gorkemorakbicen/28V-Power-Control-Interface/docs/BOM.xlsx

Sheet: BOM - Gruplu
Referanslar | Adet | Tür | Değer | Üretici | MPN | Footprint | Montaj | Kaynak URL
L1 | 1 | Bobin | 47uH | Coilcraft | MSS1260T-473MLD | Inductor_SMD:L_Coilcraft_MSS1260-XXX | Montaj | https://www.coilcraft.com/en-us/products/power/shielded-inductors/ferrite-drum/mss-mos/mss1260t/mss1260t-473/
SW1 | 1 | Buton | SW_Push | Omron | B3U-1000P | Button_Switch_SMD:SW_SPST_B3U-1000P | Montaj | https://omronfs.omron.com/en_US/ecb/products/pdf/en-b3u.pdf
R1 | 1 | Direnç | 3.3k | Yageo | AC1206FR-073K3L | Resistor_SMD:R_1206_3216Metric | Montaj | https://yageogroup.com/component-documentation/download/specsheet/AC1206FR-073K3L
R13 | 1 | Direnç | 1k | Yageo | AC0603FR-071KL | Resistor_SMD:R_0603_1608Metric | Montaj | https://www.digikey.com/en/products/detail/yageo/AC0603FR-071KL/2828140
R15 | 1 | Direnç | 120 (DNP) | Yageo | AC1206FR-07120RL | Resistor_SMD:R_1206_3216Metric | DNP | https://www.digikey.com/en/products/detail/yageo/AC1206FR-07120RL/5897228
R2 | 1 | Direnç | 1M | Yageo | AC0603FR-071ML | Resistor_SMD:R_0603_1608Metric | Montaj | https://www.digikey.com/en/products/detail/yageo/AC0603FR-071ML/2828141
R3 | 1 | Direnç | 200k | Yageo | AC0603FR-07200KL | Resistor_SMD:R_0603_1608Metric | Montaj | https://yageogroup.com/component-documentation/download/specsheet/AC0603FR-07200KL
R4 | 1 | Direnç | 316k | Yageo | RT0603BRD07316KL | Resistor_SMD:R_0603_1608Metric | Montaj | https://www.digikey.com/en/products/detail/yageo/RT0603BRD07316KL/6616687
R5 | 1 | Direnç | 100k | Yageo | AC0603FR-07100KL | Resistor_SMD:R_0603_1608Metric | Montaj | https://yageogroup.com/component-documentation/download/specsheet/AC0603FR-07100KL
R6 | 1 | Direnç | 41.2k | Yageo | AC0603FR-0741K2L | Resistor_SMD:R_0603_1608Metric | Montaj | https://www.digikey.com/en/products/detail/yageo/AC0603FR-0741K2L/5896114
R7 | 1 | Direnç | 100k | Yageo | RT0603BRD07100KL | Resistor_SMD:R_0603_1608Metric | Montaj | https://yageogroup.com/component-documentation/download/specsheet/RT0603BRD07100KL
R8, R10 | 2 | Direnç | 165k | Yageo | AC0603FR-07165KL | Resistor_SMD:R_0603_1608Metric | Montaj | https://www.digikey.com/en/products/detail/yageo/AC0603FR-07165KL/5895810
R9, R11, R12, R14 | 4 | Direnç | 10k | Yageo | AC0603FR-0710KL | Resistor_SMD:R_0603_1608Metric | Montaj | https://www.digikey.com/en/products/detail/yageo/AC0603FR-0710KL/2827814
D1 | 1 | Diyot/LED | BZT52C12Q | Diodes Incorporated | BZT52C12Q-7-F | Diode_SMD:D_SOD-123 | Montaj | https://www.digikey.com/en/products/detail/diodes-incorporated/BZT52C12Q-7-F/16548866
D2 | 1 | Diyot/LED | SMBJ36CA | Littelfuse | SMBJ36CA | Diode_SMD:D_SMB | Montaj | https://www.littelfuse.com/assetdocs/tvs-diodes-smbj-series-datasheet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
D3 | 1 | Diyot/LED | LED_RED | Lite-On | LTST-C190KRKT | LED_SMD:LED_0603_1608Metric | Montaj | https://www.digikey.com/en/products/detail/liteon/LTST-C190KRKT/386817
D4 | 1 | Diyot/LED | PESD2CANFD24V-T | Nexperia | PESD2CANFD24V-T | Package_TO_SOT_SMD:SOT-23 | Montaj | https://assets.nexperia.com/documents/data-sheet/PESD2CANFD24V-T.pdf
U1 | 1 | Entegre | LM5164DDA | Texas Instruments | LM5164DDAT | Package_SO:HSOP-8-1EP_3.9x4.9mm_P1.27mm_EP2.41x3.1mm_ThermalVias | Montaj | https://www.ti.com/lit/ds/symlink/lm5164.pdf?ts=1598311864250
U2 | 1 | Entegre | TLV75533PDBV | Texas Instruments | TLV75533PDBVR | Package_TO_SOT_SMD:SOT-23-5 | Montaj | http://www.ti.com/lit/ds/symlink/tlv755p.pdf
U3 | 1 | Entegre | STM32G0B1CBTx | STMicroelectronics | STM32G0B1CBT6 | Package_QFP:LQFP-48_7x7mm_P0.5mm | Montaj | https://www.st.com/resource/en/datasheet/stm32g0b1cb.pdf
U4 | 1 | Entegre | TJA1049T-3 | NXP | TJA1049T/3/1Z | Package_SO:SOIC-8_3.9x4.9mm_P1.27mm | Montaj | http://www.nxp.com/docs/en/data-sheet/TJA1049.pdf
C1 | 1 | Kondansatör | 2.2nF | Murata | GCM155R71H222KA37D | Capacitor_SMD:C_0402_1005Metric | Montaj | https://www.digikey.com/en/products/detail/murata-electronics/GCM155R71H222KA37D/1765162
C11, C13, C16, C18, C19 | 5 | Kondansatör | 100nF | Murata | GRM188R72A104KA35D | Capacitor_SMD:C_0603_1608Metric | Montaj | https://www.digikey.com/en/products/detail/murata-electronics/GRM188R72A104KA35D/702549
C12 | 1 | Kondansatör | 4.7uF | TDK | C2012X7R1C475K125AB | Capacitor_SMD:C_0805_2012Metric | Montaj | https://www.digikey.lv/en/products/detail/tdk/C2012X7R1C475K125AB/2619200
C14, C15 | 2 | Kondansatör | 10nF | Murata | GRM188R72A103KA01D | Capacitor_SMD:C_0603_1608Metric | Montaj | https://www.digikey.com/en/products/detail/murata-electronics/GRM188R72A103KA01D/2612560
C17 | 1 | Kondansatör | 1uF | Murata | GRM21BR71C105KA01L | Capacitor_SMD:C_0805_2012Metric | Montaj | https://www.digikey.com/en/products/detail/murata-electronics/GRM21BR71C105KA01L/586698
C2 | 1 | Kondansatör | 22uF/100V | Nichicon | UCZ2A220MCS1GS | Capacitor_SMD:CP_Elec_10x10 | Montaj | https://www.nichicon.com/en-us/part/ucz2a220mcs1gs/3000/
C20, C21 | 2 | Kondansatör | 12pF | TDK | CGA3E2C0G1H120J080AA | Capacitor_SMD:C_0603_1608Metric | Montaj | https://product.tdk.com/system/files/dam/doc/product/capacitor/ceramic/mlcc/catalog/mlcc_automotive_general_en.pdf
C3, C4 | 2 | Kondansatör | 2.2uF | TDK | CGA6N3X7R2A225K230AB | Capacitor_SMD:C_1210_3225Metric | Montaj | https://product.tdk.com/en/search/capacitor/ceramic/mlcc/info?part_no=CGA6N3X7R2A225K230AB
C5 | 1 | Kondansatör | 3.3nF | Murata | GRM188R72A332KA01D | Capacitor_SMD:C_0603_1608Metric | Montaj | https://www.digikey.com/en/products/detail/murata-electronics/GRM188R72A332KA01D/587141
C6 | 1 | Kondansatör | 22uF | TDK | CGA6P1X7R1C226M250AC | Capacitor_SMD:C_1210_3225Metric | Montaj | https://product.tdk.com/en/search/capacitor/ceramic/mlcc/info?part_no=CGA6P1X7R1C226M250AC
C7 | 1 | Kondansatör | 22uF (DNP) | TDK | CGA6P1X7R1C226M250AC | Capacitor_SMD:C_1210_3225Metric | DNP | https://product.tdk.com/en/search/capacitor/ceramic/mlcc/info?part_no=CGA6P1X7R1C226M250AC
C8 | 1 | Kondansatör | 82pF | TDK | CGA3E2C0G1H820J080AA | Capacitor_SMD:C_0603_1608Metric | Montaj | https://product.tdk.com/en/search/capacitor/ceramic/mlcc/info?part_no=CGA3E2C0G1H820J080AA
C9, C10 | 2 | Kondansatör | 2.2uF | Murata | GRM21BR71C225KA12L | Capacitor_SMD:C_0805_2012Metric | Montaj | https://www.digikey.com/en/products/detail/murata-electronics/GRM21BR71C225KA12L/965920
J1 | 1 | Konnektör | Screw_Terminal_01x02 | Phoenix Contact | 1715721 | TerminalBlock_Phoenix:TerminalBlock_Phoenix_MKDS-1,5-2-5.08_1x02_P5.08mm_Horizontal | Montaj | https://www.phoenixcontact.com/tr-tr/urunler/baskili-devre-levhasi-terminali-mkds-15-2-508-1715721
J2 | 1 | Konnektör | Conn_01x05_Pin | Würth Elektronik | 61300511121 | Connector_PinHeader_2.54mm:PinHeader_1x05_P2.54mm_Vertical | Montaj | https://www.digikey.com/en/products/detail/w%C3%BCrth-elektronik/61300511121/4846831
J3 | 1 | Konnektör | Screw_Terminal_01x03 | Phoenix Contact | 1715734 | TerminalBlock_Phoenix:TerminalBlock_Phoenix_MKDS-1,5-3-5.08_1x03_P5.08mm_Horizontal | Montaj | https://www.phoenixcontact.com/tr-tr/urunler/baskili-devre-levhasi-terminali-mkds-15-3-508-1715734
Y1 | 1 | Kristal | 16MHz | Kyocera | CX3225FB16000F0FZZH1 | Crystal:Crystal_SMD_3225-4Pin_3.2x2.5mm | Montaj | https://ele.kyocera.com/assets/products/crystal-device/specification/CX3225FB_10pF.pdf
Q1 | 1 | MOSFET | SQM100P10-19L | Vishay | SQM100P10-19L_GE3 | Package_TO_SOT_SMD:TO-263-3_TabPin2 | Montaj | https://www.vishay.com/docs/75583/sqm100p10-19l.pdf
F1 | 1 | Sigorta | 1A | Littelfuse | 0451001.MRL | Fuse:Fuse_Littelfuse-NANO2-451_453 | Montaj | https://www.littelfuse.com/assetdocs/fuse-451-and-453-datasheet?assetguid=533cd5cc-956c-4243-867f-6ab5a62f6ba1

Sheet: BOM - Tekil
Ref | Tür | Değer | Üretici | MPN | Footprint | Montaj | Kaynak URL
C1 | Kondansatör | 2.2nF | Murata | GCM155R71H222KA37D | Capacitor_SMD:C_0402_1005Metric | Montaj | https://www.digikey.com/en/products/detail/murata-electronics/GCM155R71H222KA37D/1765162
C2 | Kondansatör | 22uF/100V | Nichicon | UCZ2A220MCS1GS | Capacitor_SMD:CP_Elec_10x10 | Montaj | https://www.nichicon.com/en-us/part/ucz2a220mcs1gs/3000/
C3 | Kondansatör | 2.2uF | TDK | CGA6N3X7R2A225K230AB | Capacitor_SMD:C_1210_3225Metric | Montaj | https://product.tdk.com/en/search/capacitor/ceramic/mlcc/info?part_no=CGA6N3X7R2A225K230AB
C4 | Kondansatör | 2.2uF | TDK | CGA6N3X7R2A225K230AB | Capacitor_SMD:C_1210_3225Metric | Montaj | https://product.tdk.com/en/search/capacitor/ceramic/mlcc/info?part_no=CGA6N3X7R2A225K230AB
C5 | Kondansatör | 3.3nF | Murata | GRM188R72A332KA01D | Capacitor_SMD:C_0603_1608Metric | Montaj | https://www.digikey.com/en/products/detail/murata-electronics/GRM188R72A332KA01D/587141
C6 | Kondansatör | 22uF | TDK | CGA6P1X7R1C226M250AC | Capacitor_SMD:C_1210_3225Metric | Montaj | https://product.tdk.com/en/search/capacitor/ceramic/mlcc/info?part_no=CGA6P1X7R1C226M250AC
C7 | Kondansatör | 22uF (DNP) | TDK | CGA6P1X7R1C226M250AC | Capacitor_SMD:C_1210_3225Metric | DNP | https://product.tdk.com/en/search/capacitor/ceramic/mlcc/info?part_no=CGA6P1X7R1C226M250AC
C8 | Kondansatör | 82pF | TDK | CGA3E2C0G1H820J080AA | Capacitor_SMD:C_0603_1608Metric | Montaj | https://product.tdk.com/en/search/capacitor/ceramic/mlcc/info?part_no=CGA3E2C0G1H820J080AA
C9 | Kondansatör | 2.2uF | Murata | GRM21BR71C225KA12L | Capacitor_SMD:C_0805_2012Metric | Montaj | https://www.digikey.com/en/products/detail/murata-electronics/GRM21BR71C225KA12L/965920
C10 | Kondansatör | 2.2uF | Murata | GRM21BR71C225KA12L | Capacitor_SMD:C_0805_2012Metric | Montaj | https://www.digikey.com/en/products/detail/murata-electronics/GRM21BR71C225KA12L/965920
C11 | Kondansatör | 100nF | Murata | GRM188R72A104KA35D | Capacitor_SMD:C_0603_1608Metric | Montaj | https://www.digikey.com/en/products/detail/murata-electronics/GRM188R72A104KA35D/702549
C12 | Kondansatör | 4.7uF | TDK | C2012X7R1C475K125AB | Capacitor_SMD:C_0805_2012Metric | Montaj | https://www.digikey.lv/en/products/detail/tdk/C2012X7R1C475K125AB/2619200
C13 | Kondansatör | 100nF | Murata | GRM188R72A104KA35D | Capacitor_SMD:C_0603_1608Metric | Montaj | https://www.digikey.com/en/products/detail/murata-electronics/GRM188R72A104KA35D/702549
C14 | Kondansatör | 10nF | Murata | GRM188R72A103KA01D | Capacitor_SMD:C_0603_1608Metric | Montaj | https://www.digikey.com/en/products/detail/murata-electronics/GRM188R72A103KA01D/2612560
C15 | Kondansatör | 10nF | Murata | GRM188R72A103KA01D | Capacitor_SMD:C_0603_1608Metric | Montaj | https://www.digikey.com/en/products/detail/murata-electronics/GRM188R72A103KA01D/2612560
C16 | Kondansatör | 100nF | Murata | GRM188R72A104KA35D | Capacitor_SMD:C_0603_1608Metric | Montaj | https://www.digikey.com/en/products/detail/murata-electronics/GRM188R72A104KA35D/702549
C17 | Kondansatör | 1uF | Murata | GRM21BR71C105KA01L | Capacitor_SMD:C_0805_2012Metric | Montaj | https://www.digikey.com/en/products/detail/murata-electronics/GRM21BR71C105KA01L/586698
C18 | Kondansatör | 100nF | Murata | GRM188R72A104KA35D | Capacitor_SMD:C_0603_1608Metric | Montaj | https://www.digikey.com/en/products/detail/murata-electronics/GRM188R72A104KA35D/702549
C19 | Kondansatör | 100nF | Murata | GRM188R72A104KA35D | Capacitor_SMD:C_0603_1608Metric | Montaj | https://www.digikey.com/en/products/detail/murata-electronics/GRM188R72A104KA35D/702549
C20 | Kondansatör | 12pF | TDK | CGA3E2C0G1H120J080AA | Capacitor_SMD:C_0603_1608Metric | Montaj | https://product.tdk.com/system/files/dam/doc/product/capacitor/ceramic/mlcc/catalog/mlcc_automotive_general_en.pdf
C21 | Kondansatör | 12pF | TDK | CGA3E2C0G1H120J080AA | Capacitor_SMD:C_0603_1608Metric | Montaj | https://product.tdk.com/system/files/dam/doc/product/capacitor/ceramic/mlcc/catalog/mlcc_automotive_general_en.pdf
D1 | Diyot/LED | BZT52C12Q | Diodes Incorporated | BZT52C12Q-7-F | Diode_SMD:D_SOD-123 | Montaj | https://www.digikey.com/en/products/detail/diodes-incorporated/BZT52C12Q-7-F/16548866
D2 | Diyot/LED | SMBJ36CA | Littelfuse | SMBJ36CA | Diode_SMD:D_SMB | Montaj | https://www.littelfuse.com/assetdocs/tvs-diodes-smbj-series-datasheet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
D3 | Diyot/LED | LED_RED | Lite-On | LTST-C190KRKT | LED_SMD:LED_0603_1608Metric | Montaj | https://www.digikey.com/en/products/detail/liteon/LTST-C190KRKT/386817
D4 | Diyot/LED | PESD2CANFD24V-T | Nexperia | PESD2CANFD24V-T | Package_TO_SOT_SMD:SOT-23 | Montaj | https://assets.nexperia.com/documents/data-sheet/PESD2CANFD24V-T.pdf
F1 | Sigorta | 1A | Littelfuse | 0451001.MRL | Fuse:Fuse_Littelfuse-NANO2-451_453 | Montaj | https://www.littelfuse.com/assetdocs/fuse-451-and-453-datasheet?assetguid=533cd5cc-956c-4243-867f-6ab5a62f6ba1
J1 | Konnektör | Screw_Terminal_01x02 | Phoenix Contact | 1715721 | TerminalBlock_Phoenix:TerminalBlock_Phoenix_MKDS-1,5-2-5.08_1x02_P5.08mm_Horizontal | Montaj | https://www.phoenixcontact.com/tr-tr/urunler/baskili-devre-levhasi-terminali-mkds-15-2-508-1715721
J2 | Konnektör | Conn_01x05_Pin | Würth Elektronik | 61300511121 | Connector_PinHeader_2.54mm:PinHeader_1x05_P2.54mm_Vertical | Montaj | https://www.digikey.com/en/products/detail/w%C3%BCrth-elektronik/61300511121/4846831
J3 | Konnektör | Screw_Terminal_01x03 | Phoenix Contact | 1715734 | TerminalBlock_Phoenix:TerminalBlock_Phoenix_MKDS-1,5-3-5.08_1x03_P5.08mm_Horizontal | Montaj | https://www.phoenixcontact.com/tr-tr/urunler/baskili-devre-levhasi-terminali-mkds-15-3-508-1715734
L1 | Bobin | 47uH | Coilcraft | MSS1260T-473MLD | Inductor_SMD:L_Coilcraft_MSS1260-XXX | Montaj | https://www.coilcraft.com/en-us/products/power/shielded-inductors/ferrite-drum/mss-mos/mss1260t/mss1260t-473/
Q1 | MOSFET | SQM100P10-19L | Vishay | SQM100P10-19L_GE3 | Package_TO_SOT_SMD:TO-263-3_TabPin2 | Montaj | https://www.vishay.com/docs/75583/sqm100p10-19l.pdf
R1 | Direnç | 3.3k | Yageo | AC1206FR-073K3L | Resistor_SMD:R_1206_3216Metric | Montaj | https://yageogroup.com/component-documentation/download/specsheet/AC1206FR-073K3L
R2 | Direnç | 1M | Yageo | AC0603FR-071ML | Resistor_SMD:R_0603_1608Metric | Montaj | https://www.digikey.com/en/products/detail/yageo/AC0603FR-071ML/2828141
R3 | Direnç | 200k | Yageo | AC0603FR-07200KL | Resistor_SMD:R_0603_1608Metric | Montaj | https://yageogroup.com/component-documentation/download/specsheet/AC0603FR-07200KL
R4 | Direnç | 316k | Yageo | RT0603BRD07316KL | Resistor_SMD:R_0603_1608Metric | Montaj | https://www.digikey.com/en/products/detail/yageo/RT0603BRD07316KL/6616687
R5 | Direnç | 100k | Yageo | AC0603FR-07100KL | Resistor_SMD:R_0603_1608Metric | Montaj | https://yageogroup.com/component-documentation/download/specsheet/AC0603FR-07100KL
R6 | Direnç | 41.2k | Yageo | AC0603FR-0741K2L | Resistor_SMD:R_0603_1608Metric | Montaj | https://www.digikey.com/en/products/detail/yageo/AC0603FR-0741K2L/5896114
R7 | Direnç | 100k | Yageo | RT0603BRD07100KL | Resistor_SMD:R_0603_1608Metric | Montaj | https://yageogroup.com/component-documentation/download/specsheet/RT0603BRD07100KL
R8 | Direnç | 165k | Yageo | AC0603FR-07165KL | Resistor_SMD:R_0603_1608Metric | Montaj | https://www.digikey.com/en/products/detail/yageo/AC0603FR-07165KL/5895810
R9 | Direnç | 10k | Yageo | AC0603FR-0710KL | Resistor_SMD:R_0603_1608Metric | Montaj | https://www.digikey.com/en/products/detail/yageo/AC0603FR-0710KL/2827814
R10 | Direnç | 165k | Yageo | AC0603FR-07165KL | Resistor_SMD:R_0603_1608Metric | Montaj | https://www.digikey.com/en/products/detail/yageo/AC0603FR-07165KL/5895810
R11 | Direnç | 10k | Yageo | AC0603FR-0710KL | Resistor_SMD:R_0603_1608Metric | Montaj | https://www.digikey.com/en/products/detail/yageo/AC0603FR-0710KL/2827814
R12 | Direnç | 10k | Yageo | AC0603FR-0710KL | Resistor_SMD:R_0603_1608Metric | Montaj | https://www.digikey.com/en/products/detail/yageo/AC0603FR-0710KL/2827814
R13 | Direnç | 1k | Yageo | AC0603FR-071KL | Resistor_SMD:R_0603_1608Metric | Montaj | https://www.digikey.com/en/products/detail/yageo/AC0603FR-071KL/2828140
R14 | Direnç | 10k | Yageo | AC0603FR-0710KL | Resistor_SMD:R_0603_1608Metric | Montaj | https://www.digikey.com/en/products/detail/yageo/AC0603FR-0710KL/2827814
R15 | Direnç | 120 (DNP) | Yageo | AC1206FR-07120RL | Resistor_SMD:R_1206_3216Metric | DNP | https://www.digikey.com/en/products/detail/yageo/AC1206FR-07120RL/5897228
SW1 | Buton | SW_Push | Omron | B3U-1000P | Button_Switch_SMD:SW_SPST_B3U-1000P | Montaj | https://omronfs.omron.com/en_US/ecb/products/pdf/en-b3u.pdf
U1 | Entegre | LM5164DDA | Texas Instruments | LM5164DDAT | Package_SO:HSOP-8-1EP_3.9x4.9mm_P1.27mm_EP2.41x3.1mm_ThermalVias | Montaj | https://www.ti.com/lit/ds/symlink/lm5164.pdf?ts=1598311864250
U2 | Entegre | TLV75533PDBV | Texas Instruments | TLV75533PDBVR | Package_TO_SOT_SMD:SOT-23-5 | Montaj | http://www.ti.com/lit/ds/symlink/tlv755p.pdf
U3 | Entegre | STM32G0B1CBTx | STMicroelectronics | STM32G0B1CBT6 | Package_QFP:LQFP-48_7x7mm_P0.5mm | Montaj | https://www.st.com/resource/en/datasheet/stm32g0b1cb.pdf
U4 | Entegre | TJA1049T-3 | NXP | TJA1049T/3/1Z | Package_SO:SOIC-8_3.9x4.9mm_P1.27mm | Montaj | http://www.nxp.com/docs/en/data-sheet/TJA1049.pdf
Y1 | Kristal | 16MHz | Kyocera | CX3225FB16000F0FZZH1 | Crystal:Crystal_SMD_3225-4Pin_3.2x2.5mm | Montaj | https://ele.kyocera.com/assets/products/crystal-device/specification/CX3225FB_10pF.pdf

Sheet: Okuma Kilavuzu
28 V POWER CONTROL INTERFACE — BOM
Toplam footprint | 52
Montajlı bileşen | 50
DNP bileşen | 2
Grupta satır sayısı | 40
Kaynak | KiCad son yüklenen ZIP
Tarih | 16.10.2026
İçerik | Birim fiyat / stok bilgisi doğrulanmadı
KULLANIM VE SINIRLAR
BOM, fiziksel PCB üzerindeki 52 bileşen referansını temel alır. Şematik güç sembolleri (GND/PWR_FLAG) montaj parçası olmadığından dışlanmıştır. C7 ve R15 DNP olarak ayrı tutulmuştur. MPN ve üretici bilgileri şematikteki alanlardan aktarılmıştır; siparişten önce MPN geçerliliği, paket/footprint uyumu, tedarik durumu ve alternatifler üretici/tedarikçi üzerinden yeniden teyit edilmelidir. Fiyatlar eklenmemiştir.
