gorkemorakbicen/28V-Power-Control-Interface/docs/Complete_Schematic.pdf

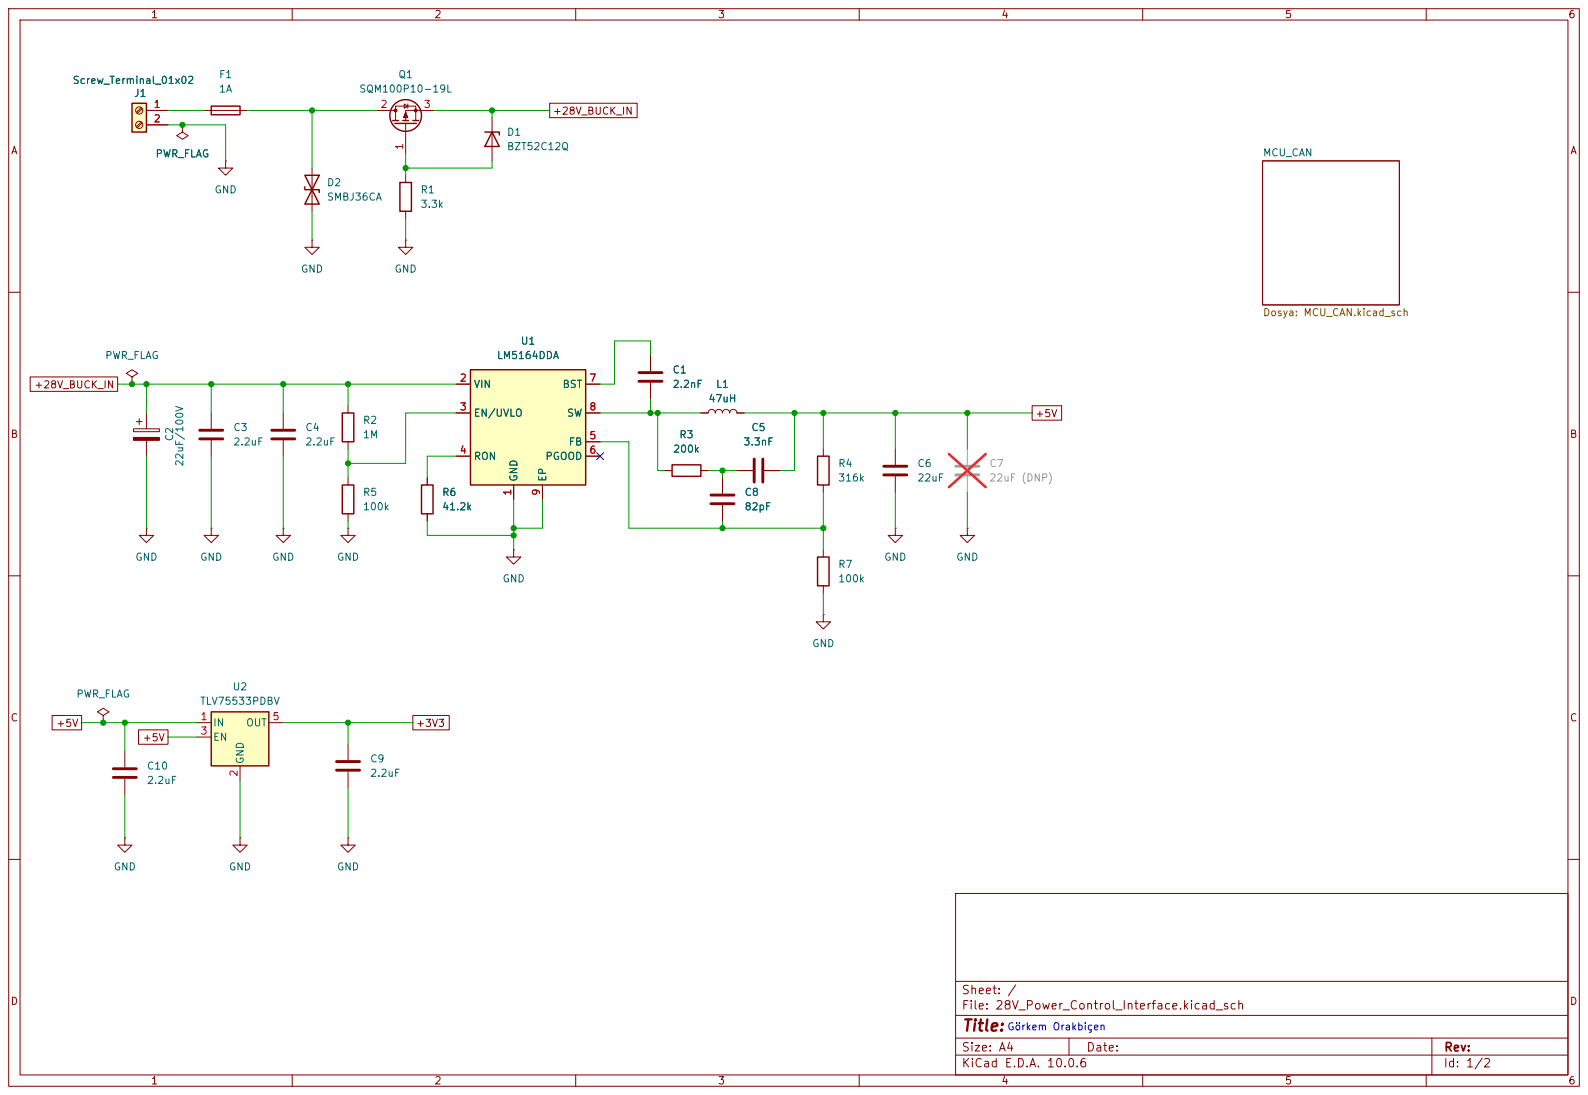
[picture p10: page 1]

Size: A4 | Rev:
KiCad E.D.A. 10.0.6 | Id: 1/2

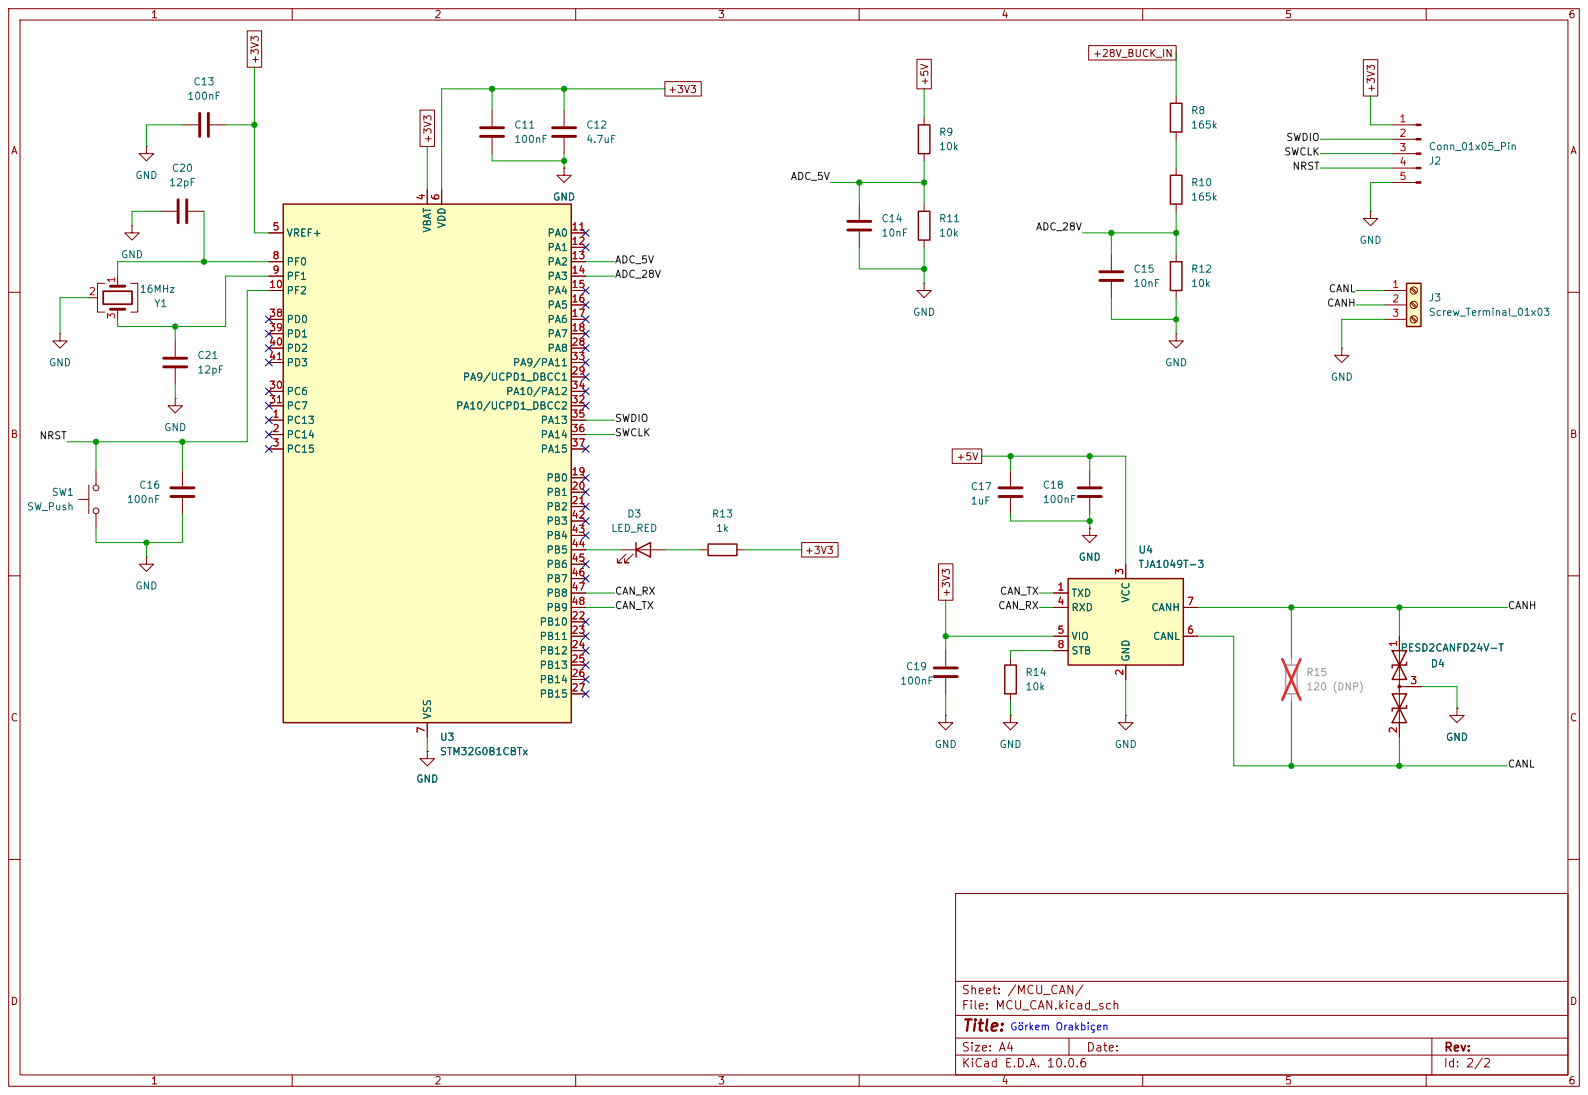
[picture p11: page 2]

Size: A4 | Rev:
KiCad E.D.A. 10.0.6 | Id: 2/2
