gorkemorakbicen/28V-Power-Control-Interface/docs/PCB_Layer_Exports.pdf

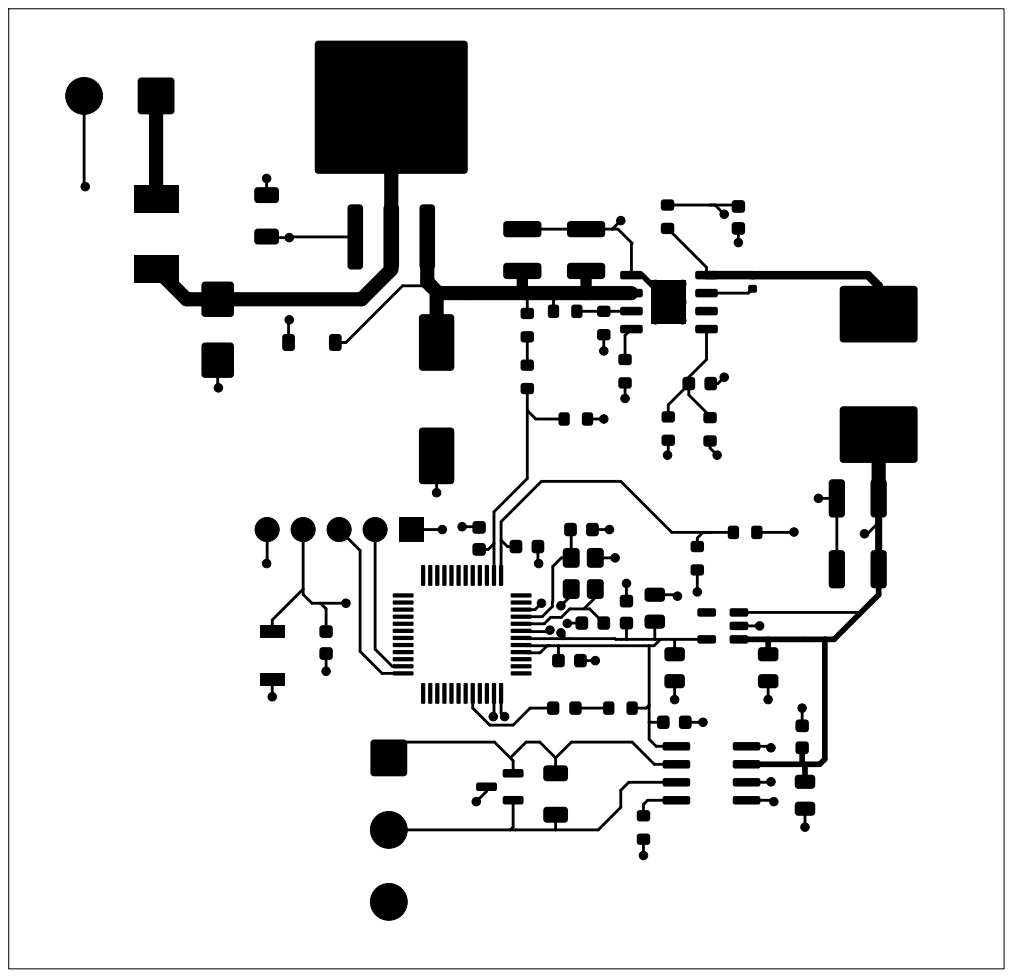
[picture p12: page 1]

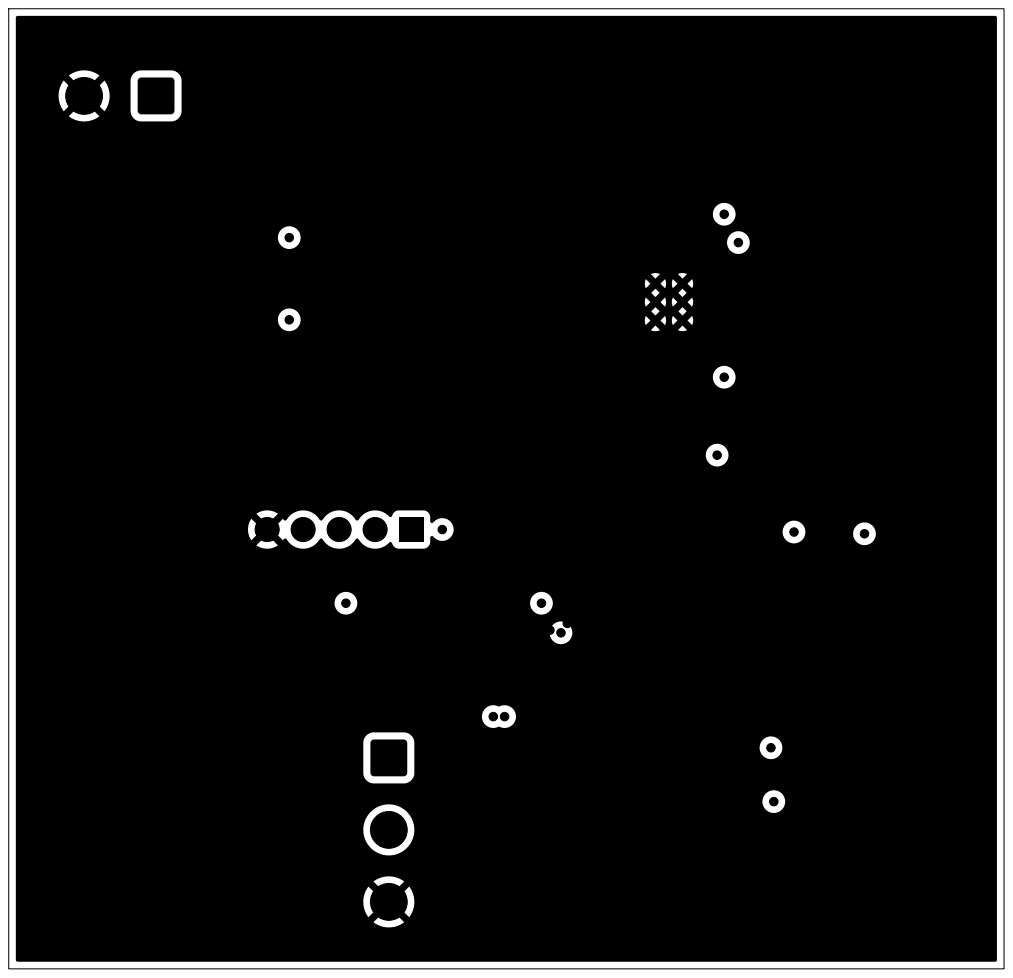
[picture p13: page 2]

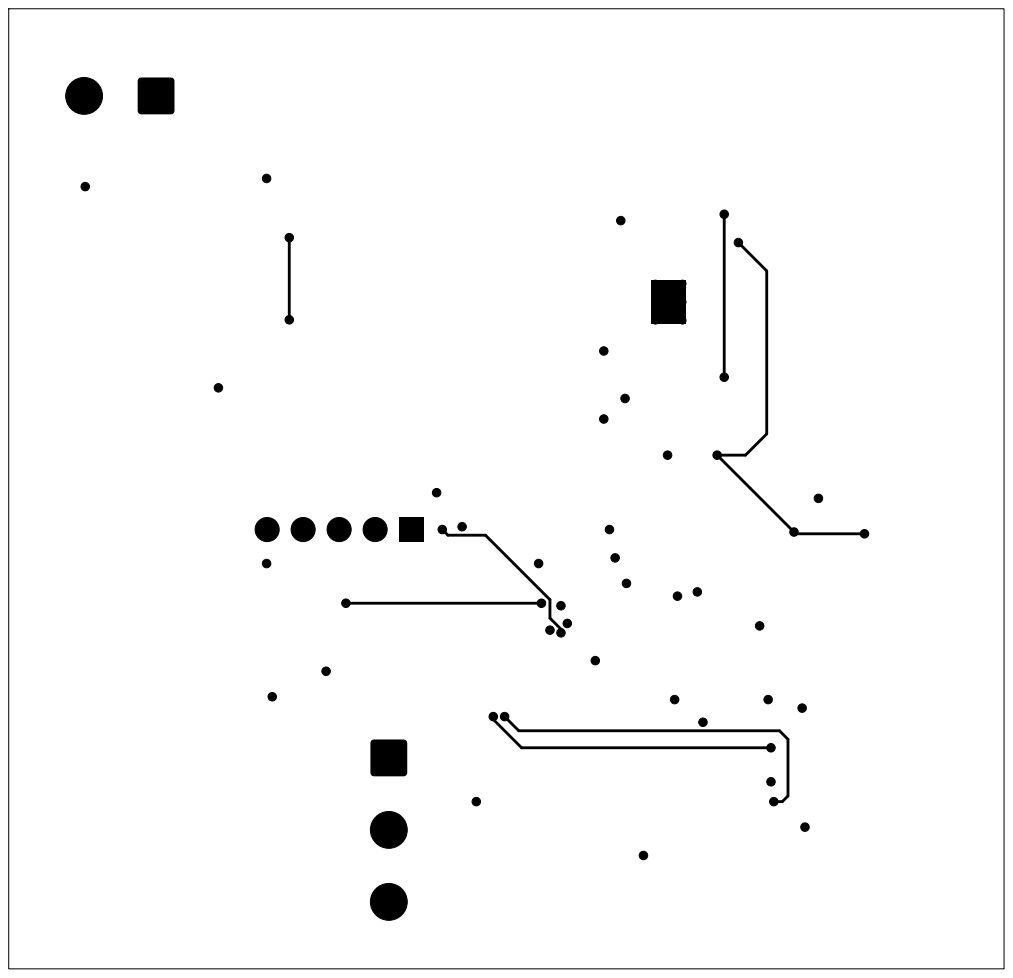
[picture p14: page 4]
