gorkemorakbicen/28V-Power-Control-Interface/docs/PCB_Top_Layer_View.pdf

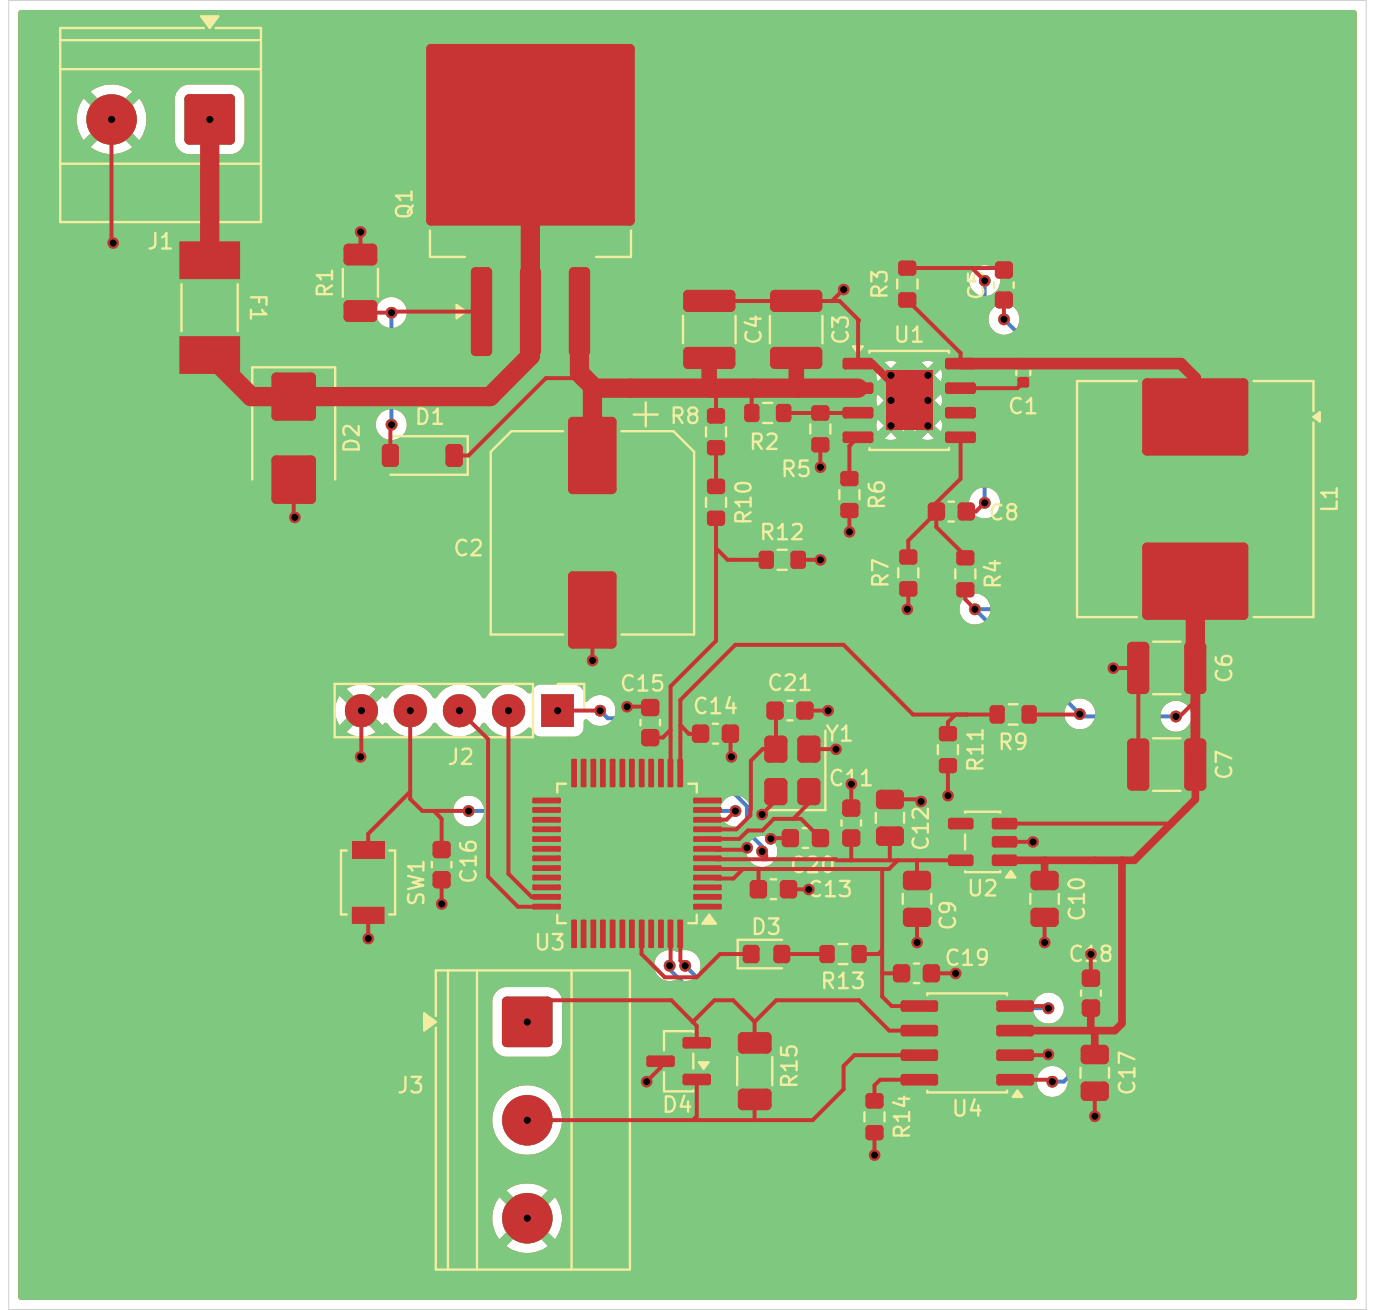
[picture p15: page 1]
