gorkemorakbicen/28V-Power-Control-Interface/hardware/28V_Power_Control_Interface.kicad_pcb

## KiCad design hardware/28V_Power_Control_Interface.kicad_pcb (2026-11-04)

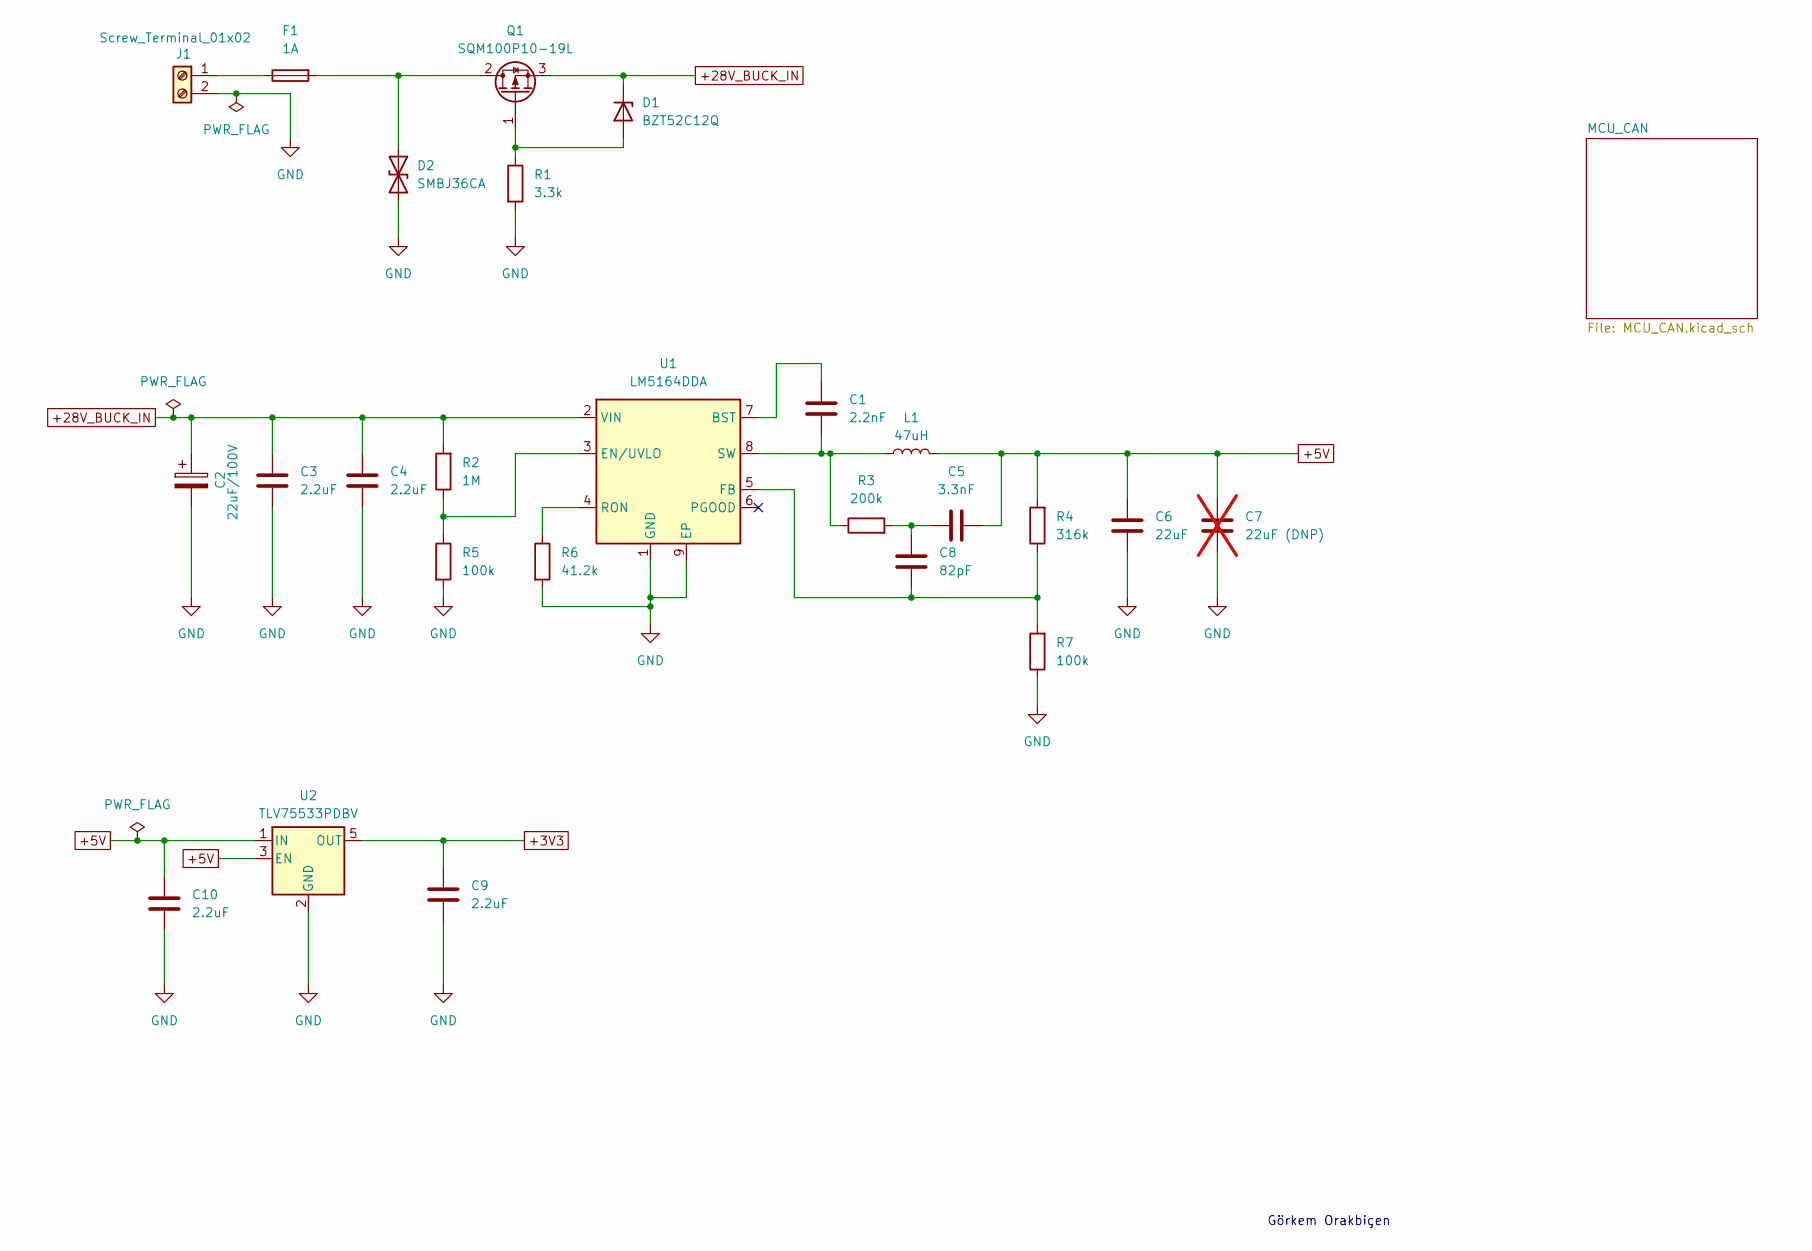
[picture p16: schematic 28V_Power_Control_Interface.kicad_sch]

Parts:
C1: 2.2nF; C_0402_1005Metric; MPN GCM155R71H222KA37D
C2: 22uF/100V; CP_Elec_10x10; MPN UCZ2A220MCS1GS
C3, C4: 2.2uF; C_1210_3225Metric; MPN CGA6N3X7R2A225K230AB
C5: 3.3nF; C_0603_1608Metric; MPN GRM188R72A332KA01D
C6: 22uF; C_1210_3225Metric; MPN CGA6P1X7R1C226M250AC
C7: 22uF (DNP); C_1210_3225Metric; MPN CGA6P1X7R1C226M250AC; not fitted
C8: 82pF; C_0603_1608Metric; MPN CGA3E2C0G1H820J080AA
C9, C10: 2.2uF; C_0805_2012Metric; MPN GRM21BR71C225KA12L
D1: BZT52C12Q; D_SOD-123; MPN BZT52C12Q-7-F
D2: SMBJ36CA; D_SMB; MPN SMBJ36CA
F1: 1A; Fuse_Littelfuse-NANO2-451_453; MPN 0451001.MRL
J1: Screw_Terminal_01x02; TerminalBlock_Phoenix_MKDS-1,5-2-5.08_1x02_P5.08mm_Horizont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; MPN 1715721
L1: 47uH; L_Coilcraft_MSS1260-XXX; MPN MSS1260T-473MLD
Q1: SQM100P10-19L; TO-263-3_TabPin2; MPN SQM100P10-19L_GE3
R1: 3.3k; R_1206_3216Metric; MPN AC1206FR-073K3L
R2: 1M; R_0603_1608Metric; MPN AC0603FR-071ML
R3: 200k; R_0603_1608Metric; MPN AC0603FR-07200KL
R4: 316k; R_0603_1608Metric; MPN RT0603BRD07316KL
R5: 100k; R_0603_1608Metric; MPN AC0603FR-07100KL
R6: 41.2k; R_0603_1608Metric; MPN AC0603FR-0741K2L
R7: 100k; R_0603_1608Metric; MPN RT0603BRD07100KL
U1: LM5164DDA; HSOP-8-1EP_3.9x4.9mm_P1.27mm_EP2.41x3.1mm_ThermalVias; MPN LM5164DDAT
U2: TLV75533PDBV; SOT-23-5; MPN TLV75533PDBVR

Connections:
+3V3: C9.1, U2.5 (OUT); also elsewhere on the board
+5V: C5.1, C6.2, C7.2, C10.1, L1.2, R4.2, U2.1 (IN), U2.3 (EN); also elsewhere on the board
+28V_BUCK_IN: C2.1, C3.2, C4.2, D1.1 (K), Q1.3 (S), R2.2, U1.2 (VIN); also elsewhere on the board
GND: C2.2, C3.1, C4.1, C6.1, C7.1, C9.2, C10.2, D2.2 (A2), J1.2, R1.2, R5.2, R6.2, R7.1, U1.1 (GND), U1.9 (EP), U2.2 (GND); also elsewhere on the board
unnamed: C5.2, C8.2, R3.2
unnamed: D1.2 (A), Q1.1 (G), R1.1
unnamed: D2.1 (A1), F1.2, Q1.2 (D)
unnamed: F1.1, J1.1
unnamed: C1.2, U1.7 (BST)
unnamed: R2.1, R5.1, U1.3 (EN/UVLO)
unnamed: C8.1, R4.1, R7.2, U1.5 (FB)
unnamed: R6.1, U1.4 (RON)
unnamed: C1.1, L1.1, R3.1, U1.8 (SW)

Notes on the sheet:
Görkem Orakbiçen

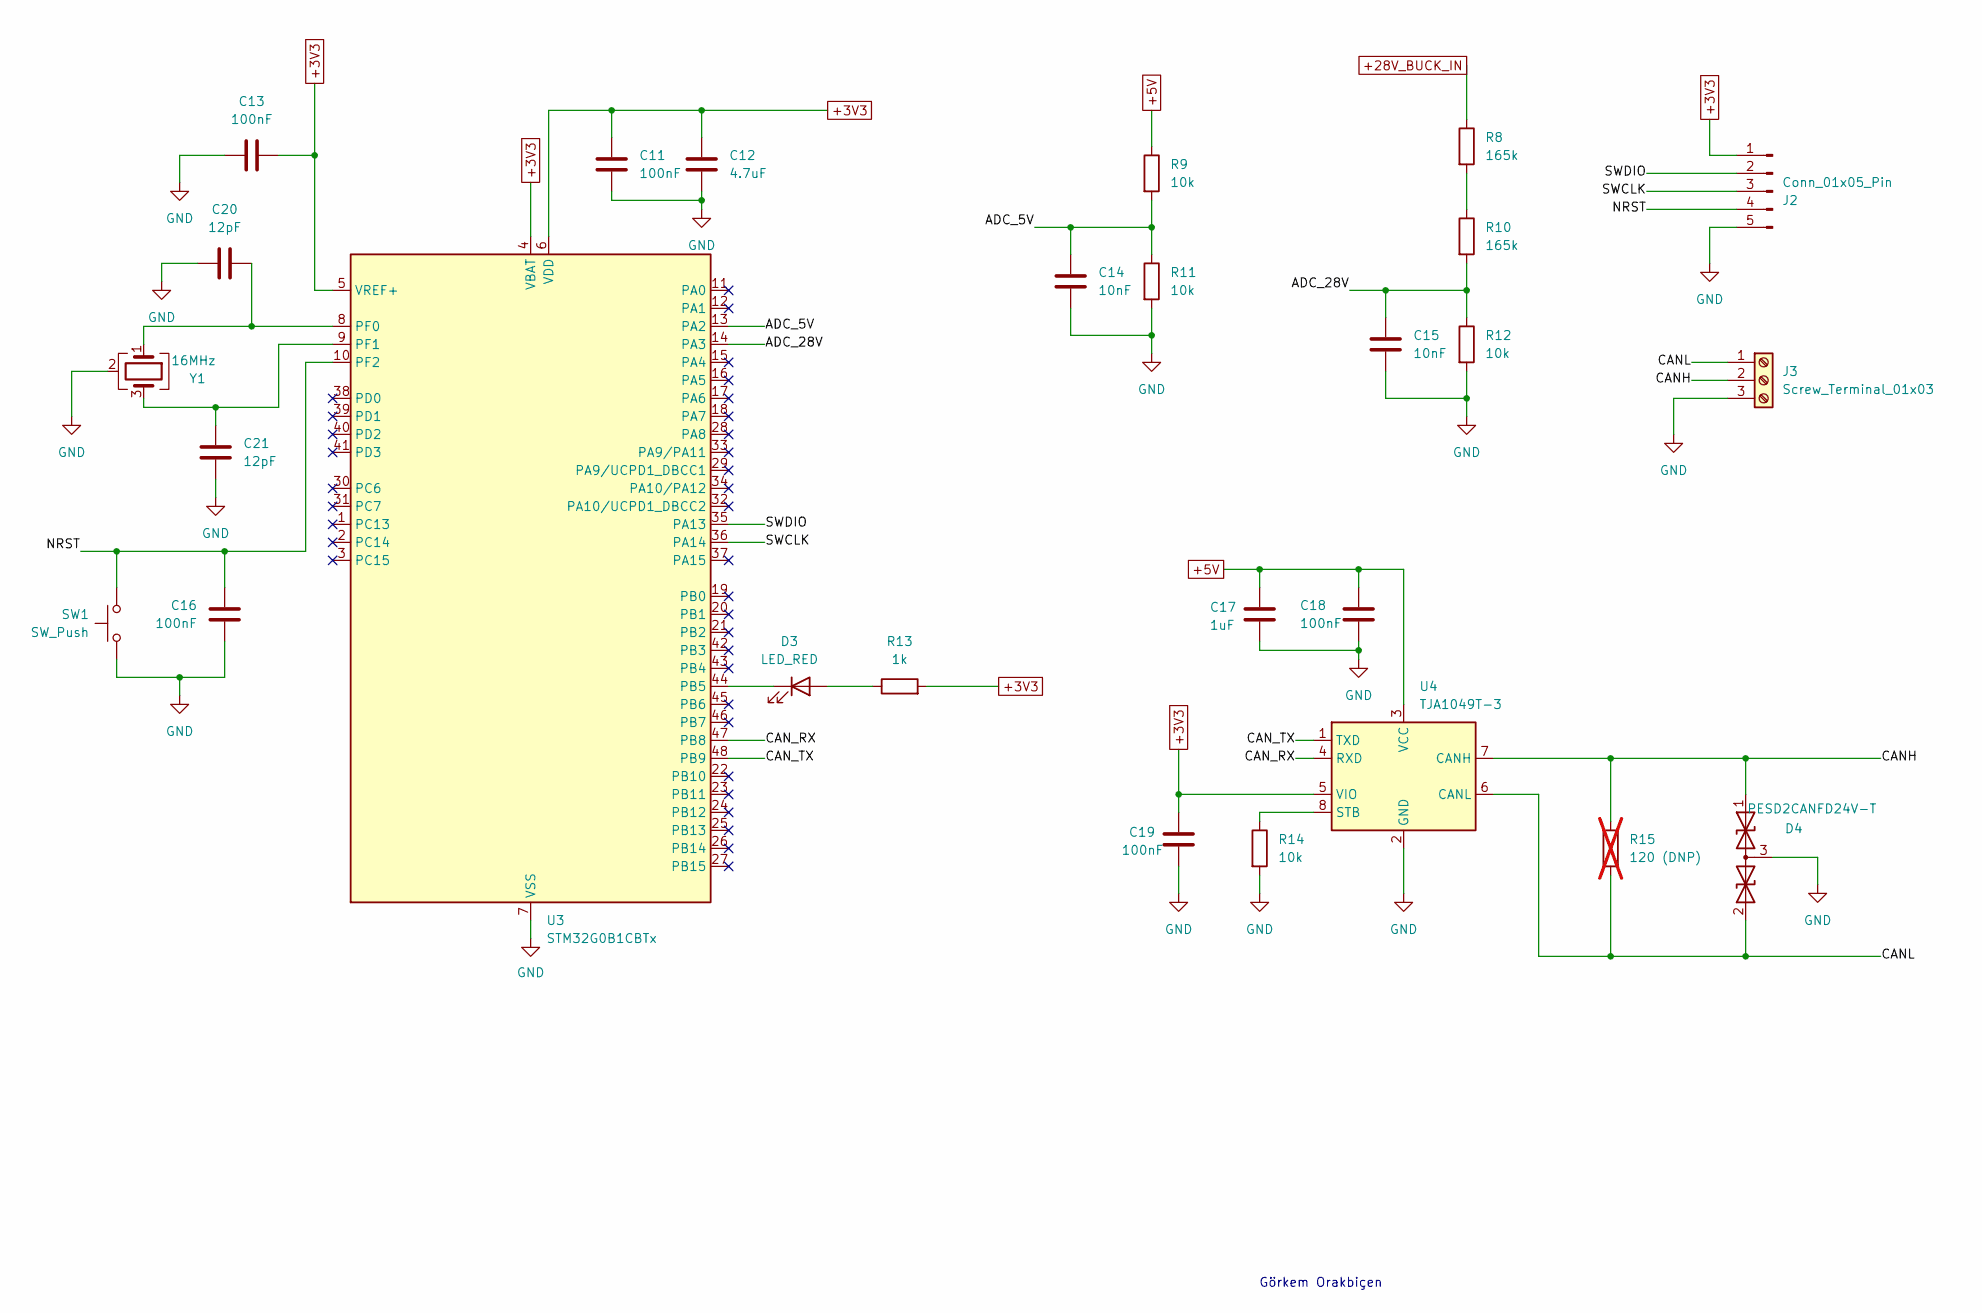
[picture p17: schematic MCU_CAN.kicad_sch]

Parts:
C11, C13, C16, C18, C19: 100nF; C_0603_1608Metric; MPN GRM188R72A104KA35D
C12: 4.7uF; C_0805_2012Metric; MPN C2012X7R1C475K125AB
C14, C15: 10nF; C_0603_1608Metric; MPN GRM188R72A103KA01D
C17: 1uF; C_0805_2012Metric; MPN GRM21BR71C105KA01L
C20, C21: 12pF; C_0603_1608Metric; MPN CGA3E2C0G1H120J080AA
D3: LED_RED; LED_0603_1608Metric; MPN LTST-C190KRKT
D4: PESD2CANFD24V-T; SOT-23; MPN PESD2CANFD24V-T
J2: Conn_01x05_Pin; PinHeader_1x05_P2.54mm_Vertical; MPN 61300511121
J3: Screw_Terminal_01x03; TerminalBlock_Phoenix_MKDS-1,5-3-5.08_1x03_P5.08mm_Horizont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; MPN 1715734
R8, R10: 165k; R_0603_1608Metric; MPN AC0603FR-07165KL
R9, R11, R12, R14: 10k; R_0603_1608Metric; MPN AC0603FR-0710KL
R13: 1k; R_0603_1608Metric; MPN AC0603FR-071KL
R15: 120 (DNP); R_1206_3216Metric; MPN AC1206FR-07120RL; not fitted
SW1: SW_Push; SW_SPST_B3U-1000P; MPN B3U-1000P
U3: STM32G0B1CBTx; LQFP-48_7x7mm_P0.5mm; MPN STM32G0B1CBT6
U4: TJA1049T-3; SOIC-8_3.9x4.9mm_P1.27mm; MPN TJA1049T/3/1Z
Y1: 16MHz; Crystal_SMD_3225-4Pin_3.2x2.5mm; MPN CX3225FB16000F0FZZH1

Connections:
+3V3: C11.1, C12.1, C13.2, C19.1, J2.1, R13.2, U3.4 (VBAT), U3.5 (VREF+), U3.6 (VDD), U4.5 (VIO); also elsewhere on the board
+5V: C17.1, C18.1, R9.1, U4.3 (VCC); also elsewhere on the board
+28V_BUCK_IN: R8.1; also elsewhere on the board
/MCU_CAN/ADC_5V: C14.1, R9.2, R11.1, U3.13 (PA2)
/MCU_CAN/ADC_28V: C15.1, R10.2, R12.1, U3.14 (PA3)
/MCU_CAN/CANH: D4.1 (A1), J3.2, R15.1, U4.7 (CANH)
/MCU_CAN/CANL: D4.2 (A2), J3.1, R15.2, U4.6 (CANL)
/MCU_CAN/CAN_RX: U3.47 (PB8), U4.4 (RXD)
/MCU_CAN/CAN_TX: U3.48 (PB9), U4.1 (TXD)
/MCU_CAN/NRST: C16.2, J2.4, SW1.1, U3.10 (PF2)
/MCU_CAN/SWCLK: J2.3, U3.36 (PA14)
/MCU_CAN/SWDIO: J2.2, U3.35 (PA13)
GND: C11.2, C12.2, C13.1, C14.2, C15.2, C16.1, C17.2, C18.2, C19.2, C20.2, C21.2, D4.3 (common), J2.5, J3.3, R11.2, R12.2, R14.2, SW1.2, U3.7 (VSS), U4.2 (GND), Y1.2 (G), Y1.4 (G); also elsewhere on the board
unnamed: D3.2 (A), R13.1
unnamed: D3.1 (K), U3.44 (PB5)
unnamed: R8.2, R10.1
unnamed: C20.1, U3.8 (PF0), Y1.1
unnamed: C21.1, U3.9 (PF1), Y1.3
unnamed: R14.1, U4.8 (STB)

Notes on the sheet:
Görkem Orakbiçen

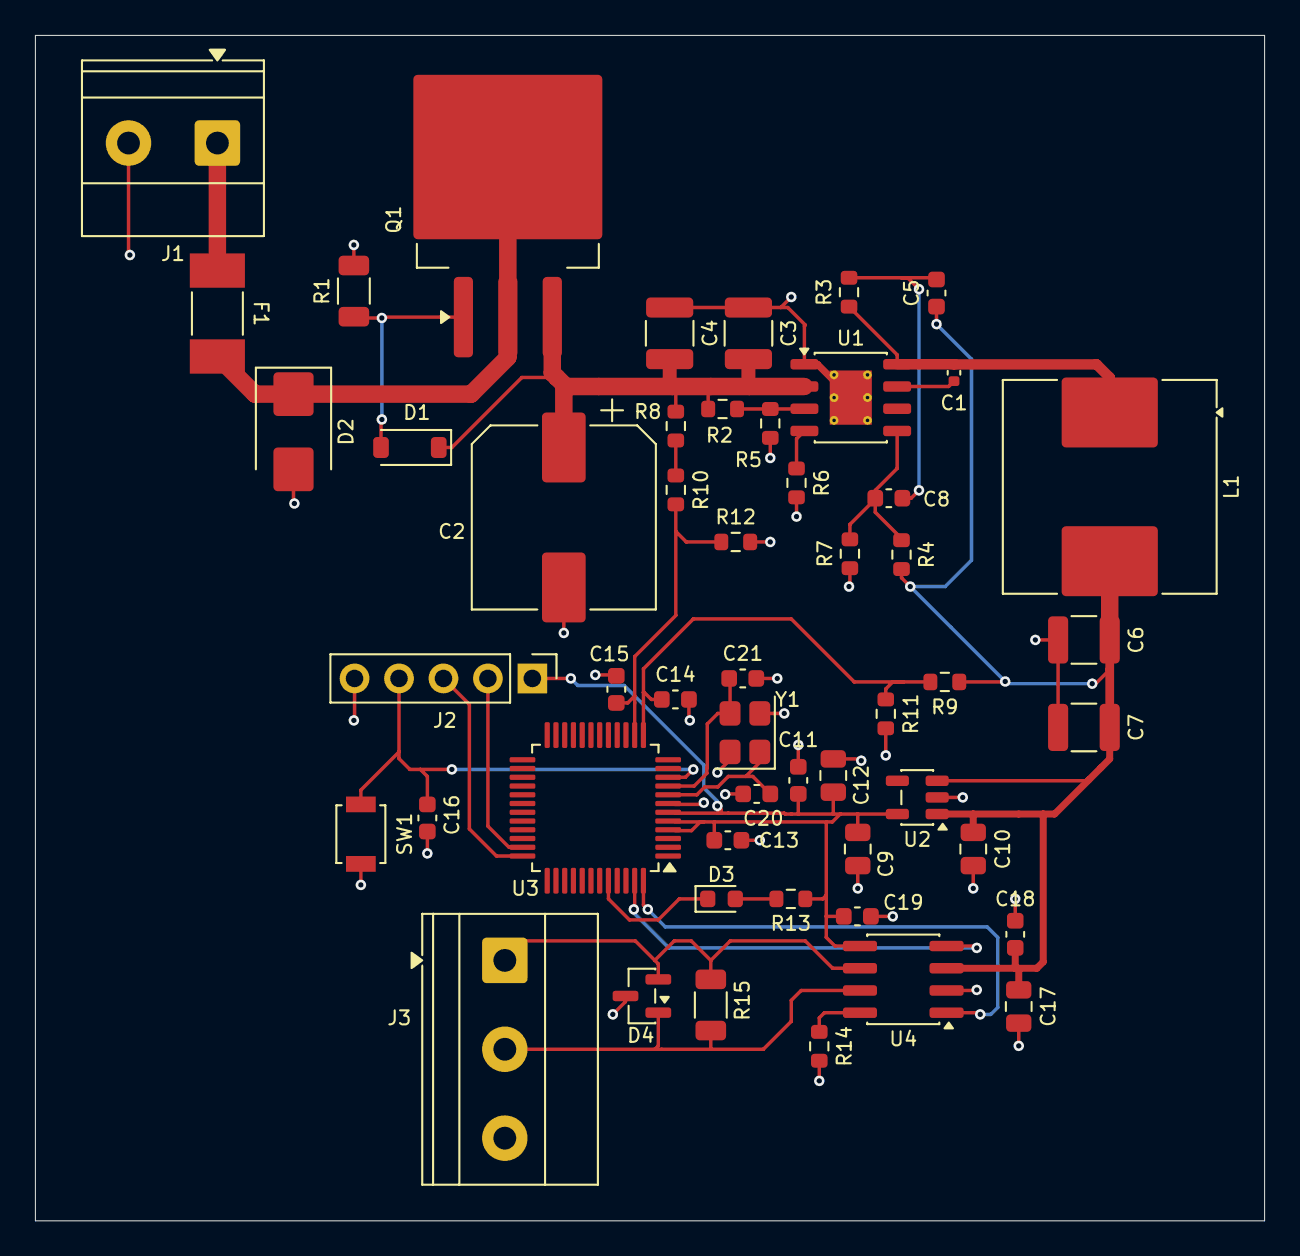
[picture p18: board 28V_Power_Control_Interface.kicad_pcb from above]

Board: 4 copper layers, 70.2 x 67.8 mm, 52 parts (0 on the bottom side), 28 nets.
